vladkorotnev/SMPEmu/(list of files, cad)

Other CAD files:
pdp/pdpfw.obj
