vladkorotnev/SMPEmu/(threads)

Thread 3 (2018-01-26):

Check if the energy_saving branch works with the new changes

vladkorotnev, 2018-01-26:
1. Merge the upstream prototype changes to the energy_saving branch
2. Test on real hardware or programmer

vladkorotnev, 2018-01-28:
Not working; leave this off for now, and make a working prototype a top-priority task.

Closed 2018-01-28.

Thread 5 (2018-01-28):

More hardware vs. emulated bugs

vladkorotnev, 2018-01-28:
The keyboard works on the emulator, but not on the real MK90, also appears that the file list won't display too (the test shot doesn't have "TODO" on display)

vladkorotnev, 2018-02-11:
File list → #7

vladkorotnev, 2018-02-13:
According to http://piotr433.archives.genjit.su/mk90hwe.htm:

`Pressing a key also causes an interrupt request to the vector at address $00C8.`
...
`$E814 - control and status register, byte size`
...
`cleared bit 4 enables external interrupts (i.e. CLK signal in the slave mode) to the vector $00C8, lowest priority`

Todo: check if bit 4 is set/re-set according to the code, and whether it has any effect on the keyboard prompt working or not.

vladkorotnev, 2018-02-13:
@BOOtak please test and confirm, trying various options at:

https://github.com/vladkorotnev/SMPEmu/blob/955f048e452fd348d3a555a8c84ae5adc9b91f0b/pdp/pdpfw.mac#L108

vladkorotnev, 2018-02-13:
Actually considering that `GETCH = B250h`, which in turn has `mov #342,@#SMPCS`, this line above is pointless and may cause many kinds of bugs. However we need to configure the serial port properly before contacting the KBCU, which would be

```
mov #1000, @#SMPBAUD
```

and then a call to GETCH, I suppose?

vladkorotnev, 2018-03-27:
Reported as working fine by @BOOtak

Another mystery solved

vladkorotnev, 2018-04-17:
As reported by Piotr Piatek:

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

Why did it work on @BOOtak 's device though?

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

More investigation needed, it seems!

vladkorotnev, 2018-04-17:
As explained by Piotr:

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

Will now try adding the suggested code into the prototype branch.

piotr433, 2018-04-29:
Hello Vladislav,

Sorry for the long delay.

I wanted to ask other MK-90 users to test both versions and share the results, but the file "smp0.bin" in the prototype branch crashes the calculator. There's not enough space for the instruction "jmp cont" before the interrupt vector, the code needs to be split one instruction earlier. Could you fix it, please?

Also, I repeated the test of the master branch version and, surprisingly, the keyboard sometimes works, once in 5 restarts or so.

spark-sys, 2018-05-02:
Hello.

**piotr433** asked me to test both (master and prototype) versions of the PDP side firmware on real MK-90.
I tested on two MK-90 available to me (production dates are May 1989 and Jun 1989).
Master branch version  locks the keyboard. Prototype branch version looks fine. At least the keyboard works after automatic restart :)

vladkorotnev, 2018-05-02:
@spark-sys

Hello and thanks for your help! Are you certain that you tested the latest PDP version (today's commit)? As I said above, I only rebuilt the bin file, but the h-file needed to be updated via bin2c.

If you did update it please consider making a pull request as I won't be at my computer until end of week.

Thanks!

vladkorotnev, 2018-05-04:
@piotr433 Thanks for updating `pdp.h`
@spark-sys If you tested the .bin file, then yes, it is the latest (I suppose you tested it with original SMP module rather than the GenjitsuSMP arduino-based hardware)

I guess another mystery busted for now?

Many thanks for your help guys!

spark-sys, 2018-05-04:
@vladkorotnev Yes, I tested the .bin with original SMP.

Closed 2018-05-04.

Thread 7 (2018-02-10):

Please remove duplicate EMULS call in SMPEmu code.

BOOtak, 2018-02-10:
Calling two subsequent EMULS calls on MK 90 side causing Arduino to process two subsequent List files commands incorrectly.

BOOtak, 2018-02-10:
https://github.com/vladkorotnev/SMPEmu/blob/754b309045d567896b7ae535d0b4150464406070/pdp/pdpfw.mac#L157-L159

vladkorotnev, 2018-02-11:
Xref #5
Branch → https://github.com/vladkorotnev/mk90emsr/issues/1

Closed 2018-02-11.

Thread 8 (2018-02-11):

Rewrite/Compatibility for ESP-32 and WiFi networks?

vladkorotnev, 2018-02-11:
Subj

Proposed commandset:

* 0x?? — list WiFi networks (same format as in 0xF0)
* 0x?? {bytes} [0xFF {password bytes}]  0x00 — connect WiFi network
* 0x?? {bytes} — HTTP GET
* 0x?? {bytes} [array] — HTTP POST
* 0x?? {bytes} — WebSocket Connect
* 0x?? {byte id} — WebSocket Refresh

Preferably within one MSN (e.g. 0x3N?)

vladkorotnev, 2018-02-15:
My ESP-32 just came in today, it's a DoIt breakout board with a CP2102 based programmer on it. Much more convenient than all of those usual chinese WCH crap ICs I must say!

Also I'm very impressed with the speed, a while(true) loop can yield a stable 8 MHz when doing a direct register write, with spikes up to 12 MHz

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

And it also claims the SPI goes up to 40 MHz, and not only that, I think it also has high-speed SDIO! :-)

So if the Atmega328 and it's 16MHz clock speed won't be able to put up with the task, this seems like a perfect candidate. Though, it might make more sense to split this project up into a separate repo for the PDP side bootloader, and an ESP32 version, if the Atmega would work, as an el-cheapo version.

Also I wonder what the current capability of the +5v pin on the calculator is. As in, whether can it handle a fully loaded ESP32 or not. But if it does, then that's a lot more speed plus add the WiFi, and much more... MK90 based Twitter client? VK chat client? Airin chat client? IRC? iTunes remote? Simple text-only web browser? The possibilities are truly endless! :-)

vladkorotnev, 2018-05-16:
Apparently the smp slot doesn't have enough current capacity (see #15)

Closed for now.

Closed 2018-05-16.

Thread 13 (2018-05-06):

DATA line remains in output state

vladkorotnev, 2018-05-06:
As reported by @piotr433:

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

vladkorotnev, 2018-05-06:
@BOOtak @piotr433 Please test with the new commit on prototype branch, which switches back to data input after sending each byte

piotr433, 2018-05-06:
The issue can be conveniently tested by replacing all occurrences of DDRD = B11000111 with DDRD = B11000110 and connecting a LED through a ~2.2 kohm resistor to the pin PD0. The state of the LED would then reflect the state of the DATA line direction. If the DATA pin is configured as input, the LED is faintly lit too through an ATMEGA internal pull-up resistor.
In my tests the DATA line is erroneously switched to output at the moment of confirming the file name with the key [ВК], before displaying the message "Перезагружаюсь!". My modifications described earlier in this thread actually **didn't fix** the issue, it still persists.
My ATMEGA8 board doesn't use the recommended 270 ohm resistor in series with the DATA line. Perhaps with this resistor the calculator wouldn't be blocked.
Also the SMP port can only supply a limited current, according to **spark-sys** tests up to ca. 15mA. In case of bus conflicts the current consumption would increase. My ATMEGA8 board wasn't powered from the calculator, but from an external power supply.
I will be back with more test results later.

vladkorotnev, 2018-05-06:
>  My modifications described earlier in this thread actually didn't fix the issue, it still persists.
Yep, however 93ef121 should fix it.

> ...up to ca. 15mA. In case of bus conflicts the current consumption would increase.
Hopefully 15mA is enough for an atmega + micro SD card. As for the bus conflicts, this is why it's advised to connect the IO lines through small resistors, to avoid current bursts in such cases.

piotr433, 2018-05-06:
More test results and thoughts:

Adding the series resistors to my ATMEGA8 board nor the latest update 93ef121 didn't help.

The do_send_byte procedure is used by the commands 0x00, 0x10, 0xB0, 0xD0, 0xF0. I have added more LEDs to the board to identify the culprit. I found out that the program gets stuck in the command 0x00, in the do_send_byte procedure. Removing the command 0x00 seems to cure the problem, even in the 6dbcd84 version.

What I don't understand:

1. How did the program get there in the first place?

2. Why cannot it leave the do_send_byte procedure? Perhaps the CLOCK pulses disappear in a bus conflict? Unfortunately, I don't have an oscilloscope at home. I will try to look at the bus signals tomorrow at work.

The problem occurs when the key [ВК] is pressed. In this moment the calculator sends the command 0xF1 to the SMP bus with the procedure EMUSEL. Perhaps it messes something? I will try to comment it out and see what happens.

My own crude SMP emulator didn't support the command 0x00. Adding it didn't change anything.

vladkorotnev, 2018-05-06:
Probably when the calculator queries the lock status with  0x00, it might just read one bit and deselect the cartridge, ignoring the rest?

And the send routine doesn't have a condition to exit when the SELECT signal is lost, thus getting stuck.

What is the problem with 0xF1 though? There is essentially no code currently handling that command, at least on the prototype branch, so it should be pretty much ignored.
The EMUSEL routine should just throw an ASCII string at the cartridge containing the file name to mount.

I have a logic analyzer, but don't yet have a calculator to test on, at least for the time being.

If you want, I suggest you look up "Saleae" logic analyzer clones on Aliexpress, they are very cheap (like $5 free shipping), have software for Windows/Linux/Mac, and can work up to 24 MHz. The original Saleae also has analog inputs and all kinds of safety stuff, but it's nearly 50 times more expensive :(

piotr433, 2018-05-06:
I think that I hit the nail with the command 0xF1. It is followed by data bytes which aren't processed in the "case 0xF1:" of the ATMEGA program. The 0xF1 routine should at least wait for the rising slope of the SELECT signal, otherwise the incoming data bytes will be interpreted as command codes.

piotr433, 2018-05-06:
Waiting for SELECT=1 in the 0xF1 routine indeed helps. @vladkorotnev, I leave the SMPEmu.ino modification to you. I will test the updated version ASAP.

vladkorotnev, 2018-05-06:
@piotr433 Added in def546a :-)

piotr433, 2018-05-06:
It's OK now. I'm closing the case!

Closed 2018-05-06.

Thread 15 (2018-05-16):

SMP does not power off when the calculator is off

vladkorotnev, 2018-05-16:
When the calculator is off, the module still remains powered on the VCC line.
Probably the Vcc line is just connected directly to the computer's battery input.

Proposed solutions:

* Find if it is possible to turn it off in software
* Rewrite using interrupts and sleep mode to lower the power consumption (preferred method)

@piotr433 Can you please chime in on how the Vcc line of the SMP socket is wired?

Thanks!

vladkorotnev, 2018-05-16:
Too bad, that leaves us no capacity to make a WiFi version, at least for now.
 But I hope microSD can run with an Arduino with no problem off that :-)

piotr433, 2018-05-16:
There's no guarantee that every MK-90 can supply 15mA. My earlier project of this kind failed, because it worked only with some of them. I guess that it drew too much current.
[](url)http://web.archive.org/web/20071102215701/http://www.pisi.com.pl/piotr433/mk90rcre.htm

Perhaps your device could be powered from the pin 39 of the rear expansion port? It's directly connected to the positive battery terminal. It's an ugly solution, I know...

vladkorotnev, 2018-05-17:
Is the Vbat terminal on the SMP port powered by the MK, btw?
Maybe it can be somehow repurposed to supply power?

vladkorotnev, 2018-05-17:
Also I noticed that arduino-based SMPEmu won't work if it's plugged in while the calculator is off.

I suppose this is related to the fact that standby voltage on the Vcc line of the SMP slot is 3.5V, which might be below the default BODLEVEL fuse setting by Arduino IDE.

I will also try removing the extra LEDs from the arduino to reduce current consumption.

However looking at microSD datasheets, most of them use roughly up to 50mA when writing, so it might cause a reboot of the calculator.

Seems like there is a need to somehow hardwire the emulator cartridge into the power circuits of the calculator or the battery slot...

vladkorotnev, 2018-05-17:
After removing the power LED, I was able to implement the power saving mechanism in 5c17558a2fb8a302dee02b7ef97df6629d8b9826

However some issues arised.

1. You still need to plug in the module while the calculator is active (Vcc is at 5v)
2. Sometimes the calculator doesn't deselect the module on time, which keeps it active and prevents it from going to sleep
3. Sleep mode cannot be lower than `SLEEP_MODE_ADC`. I'm not sure what this is caused by, but the SMP seems to be unreadable with any sleep mode lower than that.

@piotr433 If you could please test in regard of point № 3 and measure the new current consumption of the module, that would be very helpful :-)

piotr433, 2018-05-17:
Unfortunately, this test cannot be performed on my present ATMEGA8 board. I have just ordered an ATMEGA328 board and hope to get it within a few days.

piotr433, 2018-05-18:
Thoughts without testing - the problem is surely caused by the long startup time of the crystal oscillator (milliseconds range) and the SUT configurations bits setting. Proposed solutions:

1. Selecting the internal RC oscillator (which starts immediately) as a clock source. This choice would affect the Arduino bootloader communication reliability, though. It would be safer to burn the flash through the SPI port.

2. Not using the microcontroller power saving features, but connecting the board through an additional circuit cutting off the power when the SMP supply voltage drops below 4V.

vladkorotnev, 2018-05-18:
@piotr433 Will anything bad happen if we feed stabilized +5v into the SMP port? Because that way we could add a stabilizer and a lipo battery and turn the flash cartridge into a memory+battery pack, for even further ease of use of the calculator :-)

piotr433, 2018-05-18:
Feeding +5v into the SMP port wouldn't hurt the calculator, but wouldn't power it, either. In order to be sure I have tried this on my MK-90.

vladkorotnev, 2018-05-18:
OK, so maybe we could have a supercapacitor or a small battery inside our SMP to keep up with the current spikes of up to 30-50mA that an SD card can do?

piotr433, 2018-05-18:
It's a good observation that the increased current demand will last only for short periods of time. I like your idea!

vladkorotnev, 2018-05-18:
Do you know the proper calculation formula though? I hardly remember anything apart from the ohm's law and some RLC filters :-(

piotr433, 2018-05-18:
What do you want to calculate? The capacitor value?
When a capacitor is charged or discharged with a constant current, then the voltage across it ramps linearly according to the formula:
delta U = current * time / capacitance
Assuming current spike duration of 20 ms, current value of 50 mA and allowed voltage drop of 0.1 V we get:
capacitance = 0.05A * 0.02s / 0.1V = 10 mF

piotr433, 2018-05-18:
mF means millifarad = 1000 microfarad
10 mF = 10000 uF
Too high value would increase the loading time after power on. Loading a discharged 10000 uF capacitor with a constant current of 10 mA to 3.3 V would take:
0.01F * 3.3 V / 0.01A = 3.3 seconds

vladkorotnev, 2018-05-18:
oh, I'm not sure if small 10mF caps exist (I mean, I have some, but they are about the size of a vodka shot glass :D)

yeah but those 3.3s will be after plugging in the SMP, not when turning on the calculator. It however is interesting if the high inrush current of the empty cap charging might burn the power circuitry of the calculator...

vladkorotnev, 2018-05-18:
Oh, it seems they indeed do exist! https://www.digikey.com/product-detail/en/rubycon/16PX10000MEFC16X31.5/1189-1125-ND/3134083

The huge ones I have are for 60V, that's why they are so big it seems.

Probably 16V is a safe margin, as I doubt 6V or 10V ones exist, or if they do, that they are much smaller

piotr433, 2018-05-18:
The SMP port seems to be short-proof, but from my experience, when it is directly loaded with a capacitor > 100 uF, the calculator wouldn't turn on. A series current limiting resistor (470 ohm) would be needed.
BTW, if a capacitor is charged from a constant voltage source through a resistor, following formula applies:
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
The supply voltage required by an SD card is 3.3V, right? A voltage regulator would be needed between the capacitor an the card.

piotr433, 2018-05-19:
> Wouldn't the resistor create problems at the time the current needs to be released (e.g. During a card write)?

It would limit the SD card average current, i.e. the duty cycle (how intensively the SD card can be accessed). Some current limiter is necessary, though, otherwise the MK-90 won't turn on. Perhaps a JFET BF245C with the gate connected to source?

BTW, ensure that the capacitor is discharged before connecting it to the calculator.

vladkorotnev, 2018-05-19:
>  JFET BF245C with the gate connected to source?

Could you please provide a schematic of what you mean?

piotr433, 2018-05-19:
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
The advantage of a JFET over a resistor is its nonlinearity. At low drain-source voltage it acts as a resistor of 120 ohm, otherwise like a current source of 16 mA (values measured on my specimen). The capacitor is loaded faster than through an ordinary series resistor of 5V / 16 mA = 312 ohm.
The circuit was tested on my MK-90.

vladkorotnev, 2018-05-20:
Good point! Just need to see how well it works with current bursts of 50mA now. Probably that will only happen after I finish my graduation paper though :(

// Ak.R.

iOS/Mac/Windows & Web developer
Vaporwave/ambient producer, sound/video engineer

Genjitsu Gadget Lab Member 001
http://genjit.su

Sent from my iPhone

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

piotr433, 2018-05-30:
I had to modify the AVR program because of following issues:

1. The subroutine recvCommand() cannot handle a SELECT pulse without CLOCK pulses (which appears on the SMP bus when a key is pressed or a beep emitted). It stays then in the WAIT_CLOCK_FALL loop consuming power. A crude fix was applied to the  do_get_byte() routine.

2. The sleep / wake up code is overly complicated.

Measured current consumption:

1. No power saving (subroutine sleep_mode() commented out) - 10mA

2. SLEEP_MODE_ADC - 2mA

3. SLEEP_MODE_PWR_DOWN - less than 0.1mA (cannot measure more accurately), works only with an internal RC oscillator 8MHz with minimal startup time (HFuse=0xD9, LFuse=0xC2). This fuse modification disables the Arduino bootloader!

vladkorotnev, 2018-05-30:
I guess 2mA is enough, because the convenience of arduino bootloader is just too damn good, and 8MHz is likely too slow to read the SD card and output data at the same time.

Thanks for your help! :-)

// Ak.R.

iOS/Mac/Windows & Web developer
Vaporwave/ambient producer, sound/video engineer

Genjitsu Gadget Lab Member 001
http://genjit.su

Sent from my iPhone

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

Thread 16 (2018-05-16):

The calculator's pins are wider than the standard PLS plugs

vladkorotnev, 2018-05-16:
The calculator is using some kind of pin connector, which has wider pins than a standard PLS ribbon cable connector.

As a result, the connection is unstable when using a 6-pin ribbon rather than separate 1-pin breadboard cables.

Probably some mechanic modification to the connector on the cartridge side is needed?
Or we need to  use a different type of connector on the cartridge side altogether?

piotr433, 2018-05-16:
I found a connector with flat pins in an old car radio. Unfortunately, I couldn't identify the part number. I will ask on the sci.electronics.components newsgroup.

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

After cutting off some of the plastic it fits the SMP connector quite nicely.

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

vladkorotnev, 2018-05-16:
Oh, I think I have something like that somewhere in my parts bin, but part number would be nice :-)

vladkorotnev, 2018-10-05:
@piotr433 any news on this?

piotr433, 2018-10-05:
Unfortunately [not](https://groups.google.com/forum/#!topic/sci.electronics.components/cZjMIiFvnjA).

vladkorotnev, 2019-05-10:
Bumping an old thread it seems that this might be some sort of a JST connector. I'm in Japan now and they are very popular in many devices. I'll have a look around the catalogs when I get a chance. Too bad it's impossible to continue the project from here though.

piotr433, 2019-05-13:
I failed to find this kind of connector on the [JST web site](http://www.jst.com/).

Thread 17 (2018-05-22):

Menu won't reappear after calculator is power-cycled

vladkorotnev, 2018-05-22:
The Arduino currently doesn't have any means to detect when the calculator is off to switch back to the menu disk image.

We somehow need to detect the voltage dropping from 5 to 3.3 volts and make it into a digital signal to reset the arduino or gracefully finish all the write operations and remount the pdp driver image.

vladkorotnev, 2018-05-22:
I wonder if the atmega consumes much current while reset is low, so if we could use that voltage drop signal to keep the atmega in reset mode while the calculator is off.

piotr433, 2018-05-23:
The microcontroller draws current when it is in the reset state (ca. 7mA measured on my ATMEGA328 board), so it would drain calculator batteries.

I propose to power the microcontroller through the following circuit built with junk box parts:
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
It disconnects the power when the input voltage drops below 3.5V. Loaded with a 330 ohm resistor it turns fully on at the input voltage greater than 4.1V. The threshold voltage is a sum of:
base-emitter voltage drop = 0.68V
red LED voltage drop = 1.56V
green LED voltage drop = 1.73V
A transistor with a high current gain is preferred (I used a BC558C).
