vladkorotnev/SMPEmu/(commit log)

2018-01-24 Suppress power saving in favour of debugging
2018-01-25 Feed bytes to the MK 90 with MSB first
    as MK 90 engineers had no reason to reverse bits order in every byte read from SMP.
    [SMPEmu.ino]
2018-01-25 Check select pin state according to bus communication protocol.
    After all, it is called "protocol" for a reason.
2018-01-26 PDP side firmware rev 0.2
    [pdpfw.obj]
2018-01-26 Fix reading bytes from PROGMEM.
    [SMPEmu.ino]
2018-01-26 Improved MK90 side firmware
    [pdpfw.obj]
2018-01-26 Remove test binary, integrate PDPBoot for SMPEmu 0.2 for MK90 BASIC 1.0
    [pdpfw.obj]
2018-04-17 Trying to _properly_ fix Issue #5 as suggested by Piotr Piatek
    [pdpfw.obj]
2018-05-02 fix out-of-memory instruction (see #5)
    [pdpfw.obj]
2018-05-06 Switch data line back to input after sending a byte (see #5)
2018-05-06 Potential fix for #13
    [SMPEmu.ino]
2025-03-22 Version 0.3 - fixed label printing, backspace key support
    [pdpfw.obj]
2025-04-16 Version 1.0 - universal loader (BASIC 2.0 support)
    [pdpfw.obj]
2025-04-17 More optimizations!
    [pdpfw.obj]
2025-10-24 Reworked PDP firmware: selection menu (#22)
    * Version 2.0 - selection menu
    * Source reformatted
    * Arduino header updated
